HoriaTG/Masina-semiautonoma/prezentare licenta Enescu Horia.pdf

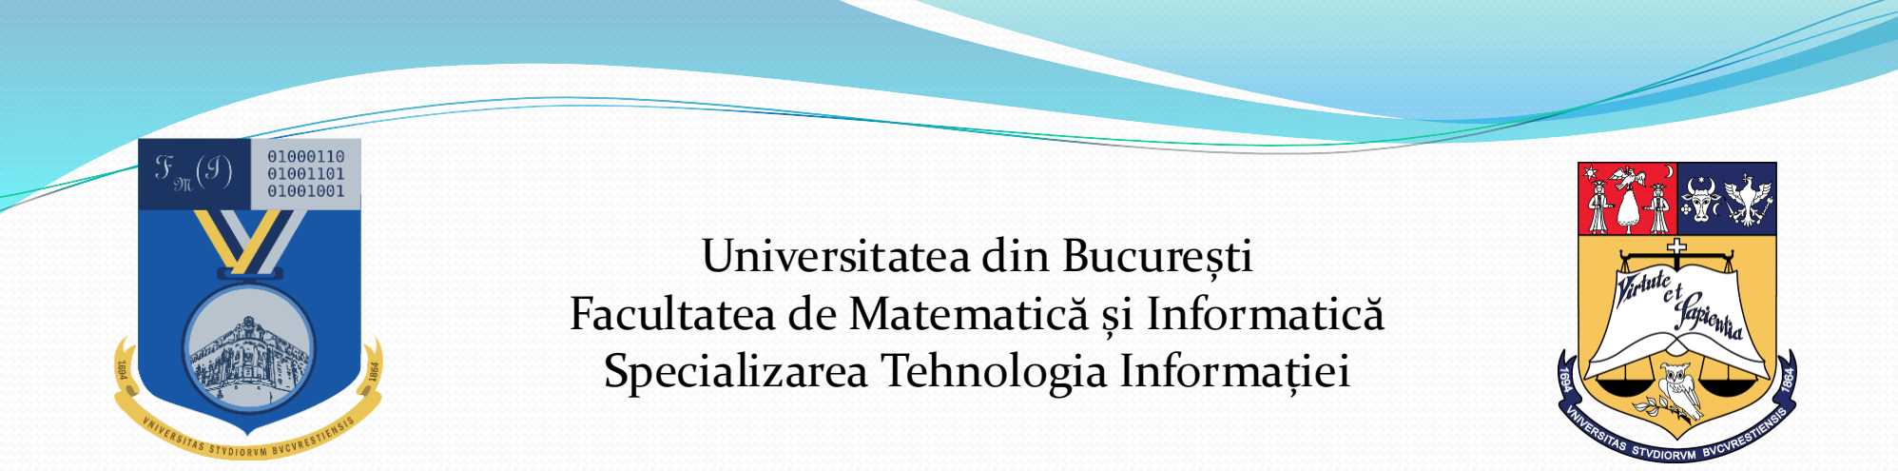
[picture p17: figure]
Universitatea din București Facultatea de Matematică și Informatică Specializarea Tehnologia Informației

Lucrare de licență

MAȘINĂ SEMIAUTONOMĂ CU
ASISTENT DE CONDUCERE

Coordonatori Științifici
Conf. Dr. Alexe Bogdan
Drd. Dumitriu Andrei | Absolvent
| Enescu Horia Teodor

București, iulie 2025

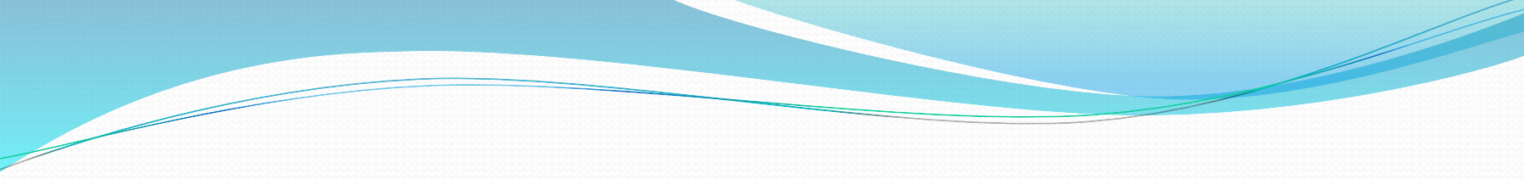
[picture p18: figure]

# Cuprins

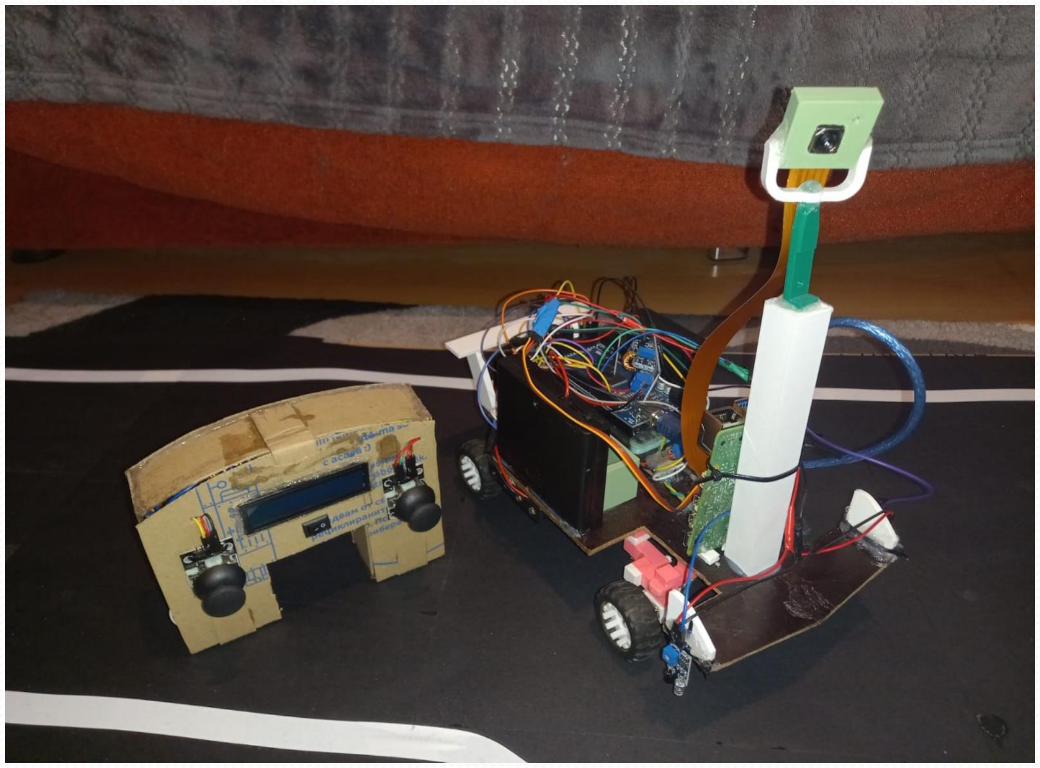
[picture p19: figure]

- Introducere
- Soluția propusă
- Implementare
- Rezultate
- Concluzii

# Introducere

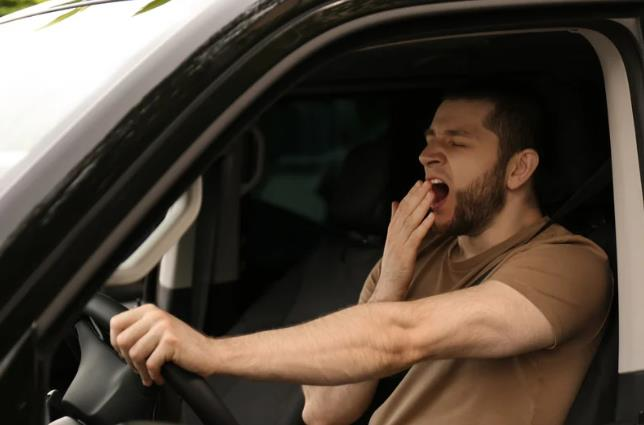
[picture p20: figure]

Peste 90% din
accidentele rutiere
sunt provocate
de erori umane
- Oboseala
- Lipsa de atenție
- Graba

# Introducere

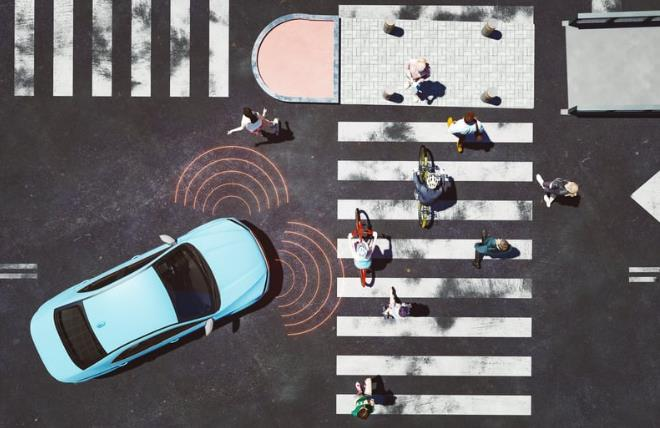
[picture p21: figure]

Mașinile
semiautonome
dotate cu senzori,
camere și algoritmi
de inteligență
artificială sprijină
șoferii.

# Soluția propusă

Proiectul de față reprezintă un prototip de astfel de mașină în miniatură, ghidată prin telecomandă, cu următoarele dotări:

- Detecția semnelor de circulație
- Detecția părăsirii benzii
- Intervenție la nevoie pentru evitarea accidentelor
- Ecran LCD informativ

# Implementare

- Obținerea unui mecanism de virare realist
- Construirea șasiului și a telecomenzii
- Configurarea unui sistem eficient de comunicare wireless
- Obținerea unui model YOLOv8 cu acuratețe ridicată pentru detecția semnelor de circulație

# Implementare

Sistemul de virare utilizat: Mecanismul Ackermann

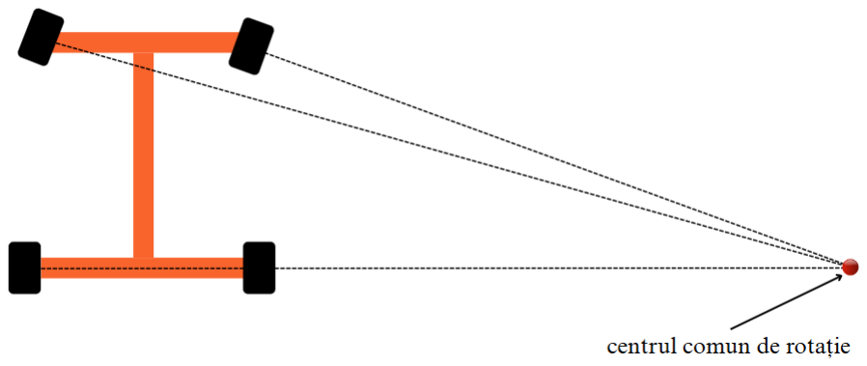
[picture p22: figure]

# Implementare

Piesă proiectată în Fusion

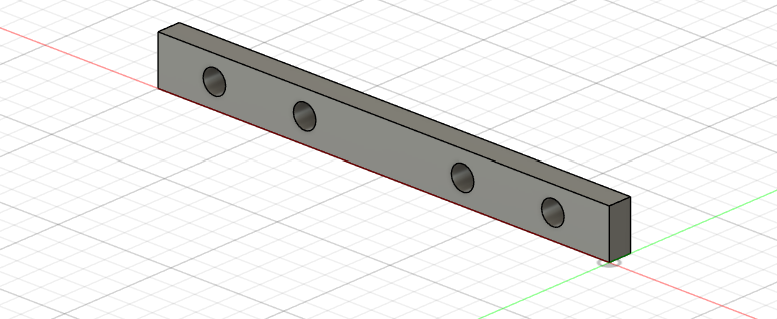
[picture p23: figure]

# Implementare

Piese printate 3D

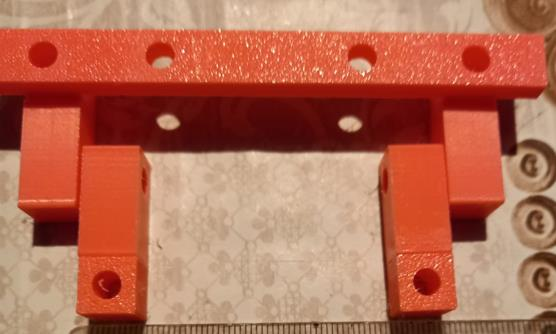
[picture p24: figure]

# Implementare

Comunicarea wireless s-a realizat prin module radio NRF24L01

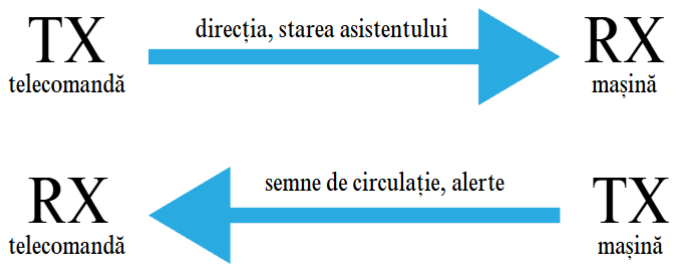
[picture p25: figure]

# Implementare

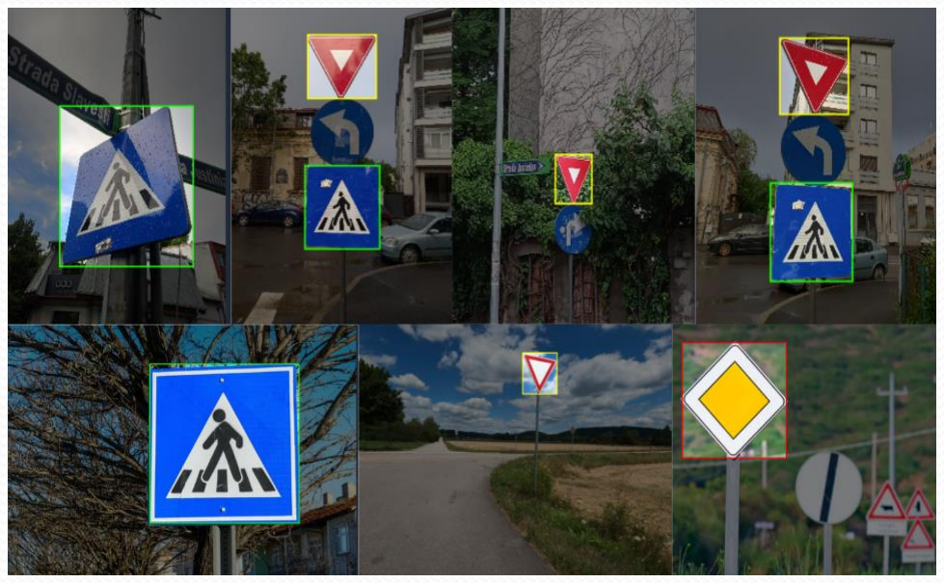
[picture p26: figure]
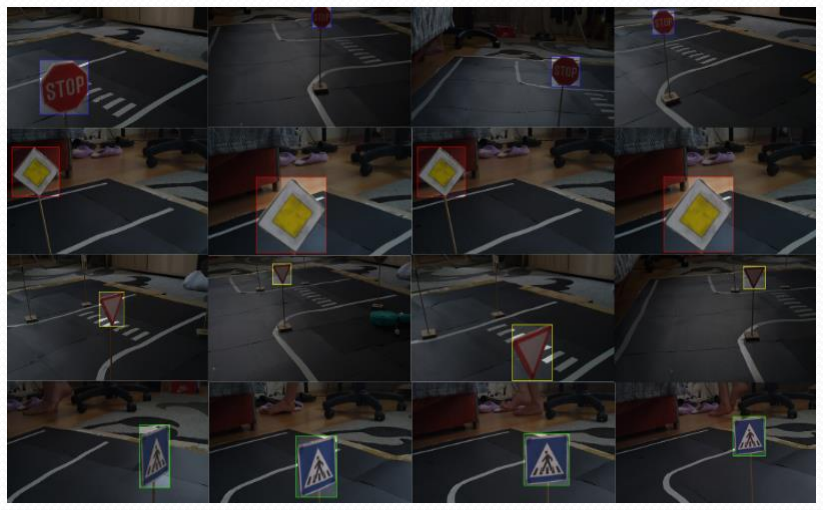
[picture p27: figure]

Antrenarea unui YOLOv8 folosind 2558 de imagini de antrenare și validare

# Rezultate

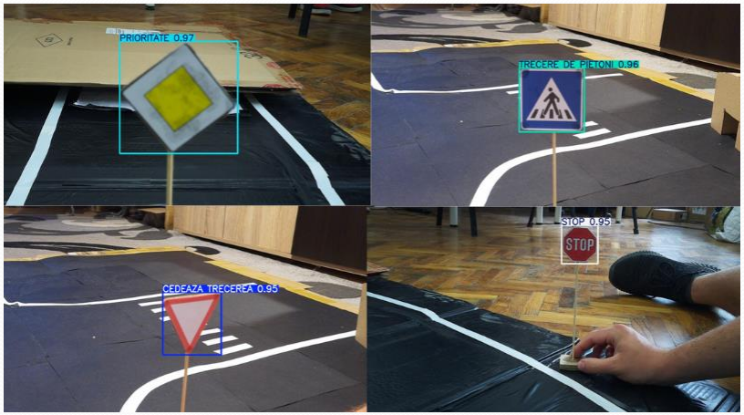
[picture p28: figure]

# Concluzii

- Proiectul îmbină multiple noțiuni de robotică, dar și noțiuni de inteligență artificială
- Poate fi îmbunătățit prin inlocuirea unor componente hardware cu altele mai performante
- Poate fi extins pe viitor, asistentul poate să intervină diferit în funcție de semnul de circulație

# Vehiculul în forma finală

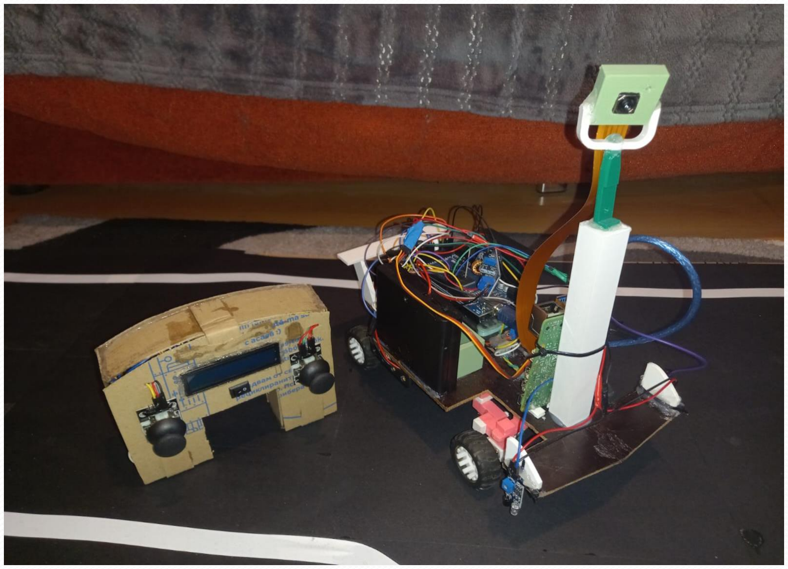
[picture p29: figure]
